OlegNaKone/electronic-analog-audio-spectrum-analizer/media/DSC00884.JPG

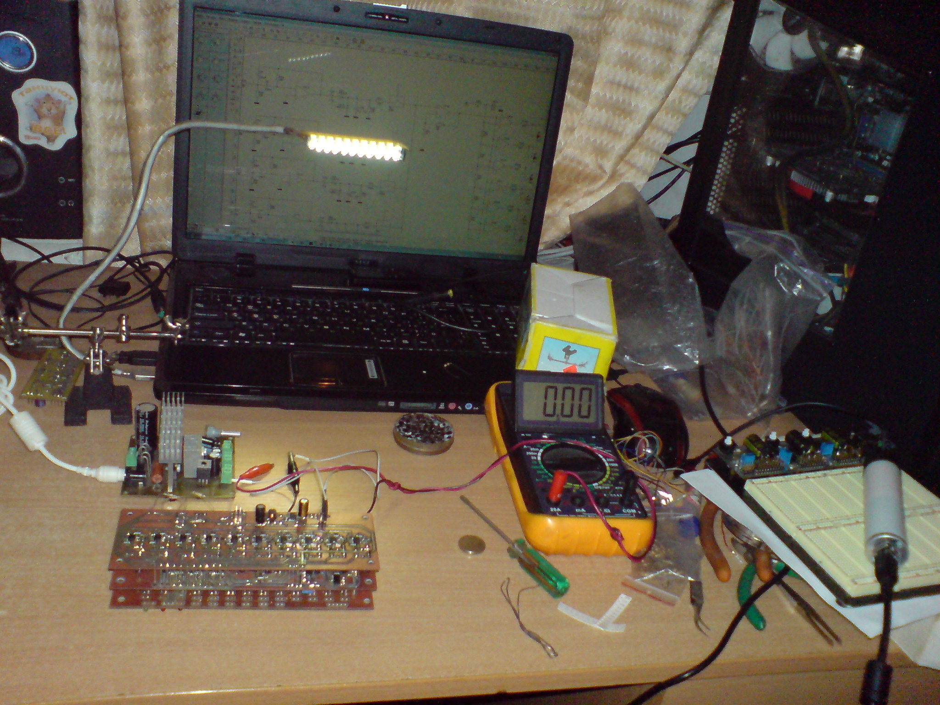
media/DSC00884.JPG
