OlegNaKone/electronic-analog-audio-spectrum-analizer/media/DSC00701.JPG

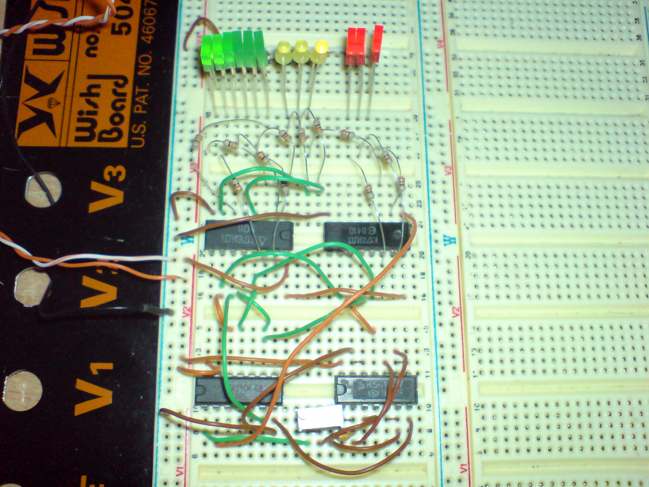
media/DSC00701.JPG
