OlegNaKone/electronic-analog-audio-spectrum-analizer/README.md

# electronic-analog-audio-spectrum-analizer
