OlegNaKone/electronic-analog-audio-spectrum-analizer/article/Логический анализатор1.jpg

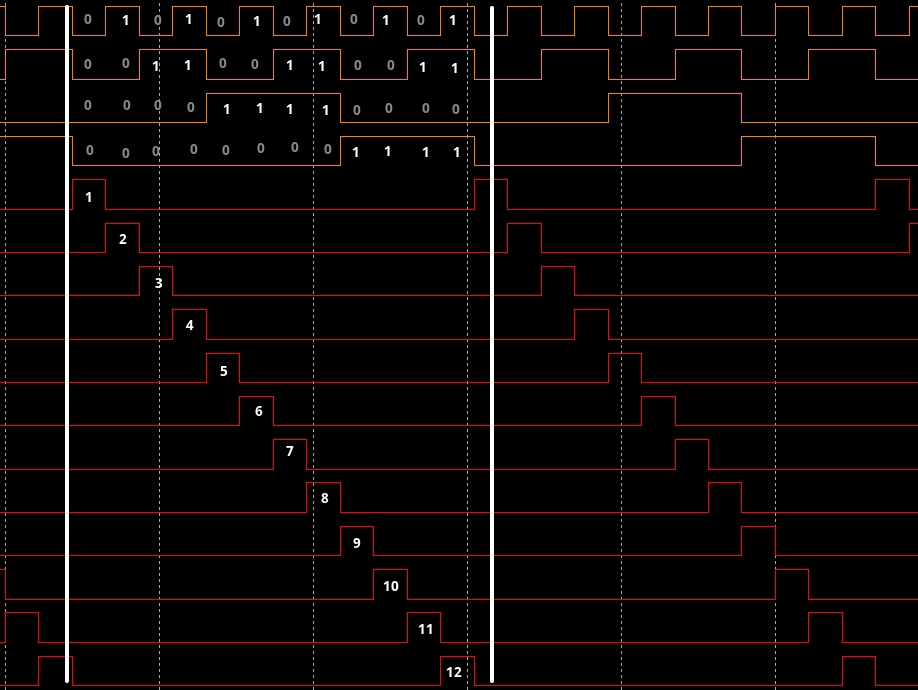
article/Логический анализатор1.jpg
