OlegNaKone/electronic-analog-audio-spectrum-analizer/article/РадиоКот   Десятиканальный аналоговый спектроанализатор_files/01.jpg

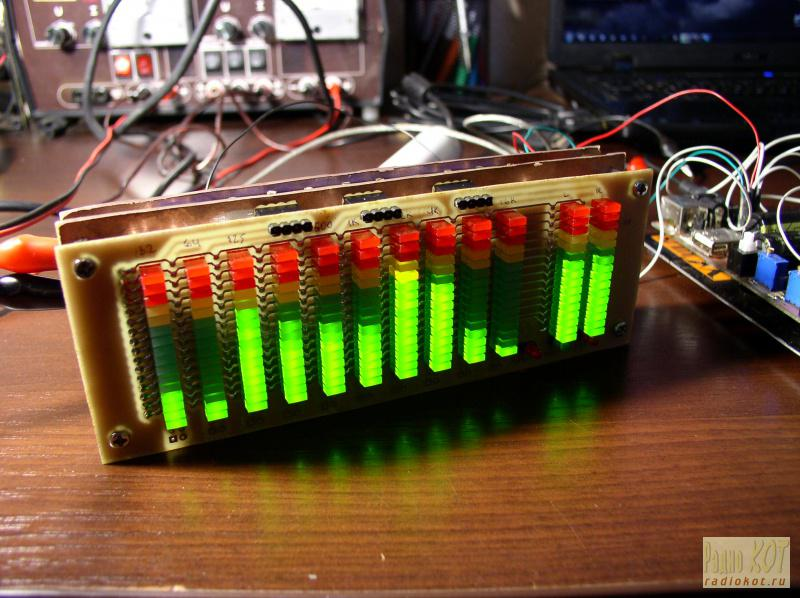
article/РадиоКот Десятиканальный аналоговый спектроанализатор_files/01.jpg
