OlegNaKone/electronic-analog-audio-spectrum-analizer/article/РадиоКот   Десятиканальный аналоговый спектроанализатор_files/03.gif

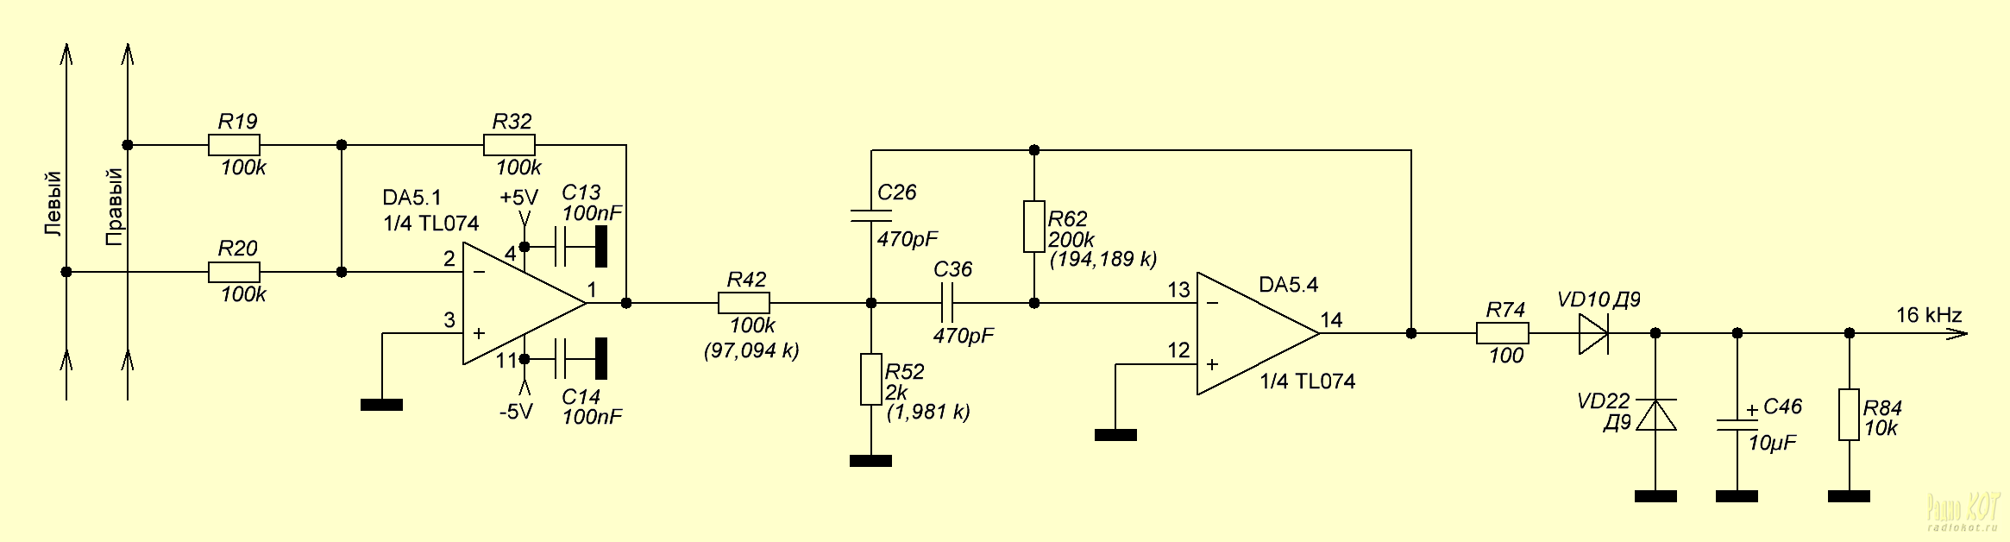
article/РадиоКот Десятиканальный аналоговый спектроанализатор_files/03.gif
