OlegNaKone/electronic-analog-audio-spectrum-analizer/article/РадиоКот   Десятиканальный аналоговый спектроанализатор_files/06_pre.gif

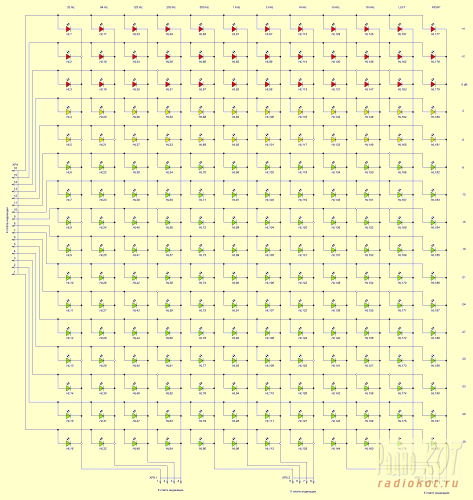
article/РадиоКот Десятиканальный аналоговый спектроанализатор_files/06_pre.gif
