OlegNaKone/electronic-analog-audio-spectrum-analizer/article/РадиоКот   Десятиканальный аналоговый спектроанализатор_files/07_pre.jpg

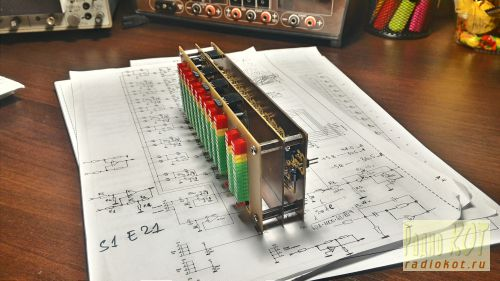
article/РадиоКот Десятиканальный аналоговый спектроанализатор_files/07_pre.jpg
