OlegNaKone/electronic-analog-audio-spectrum-analizer/article/схема блока индикаторов.GIF

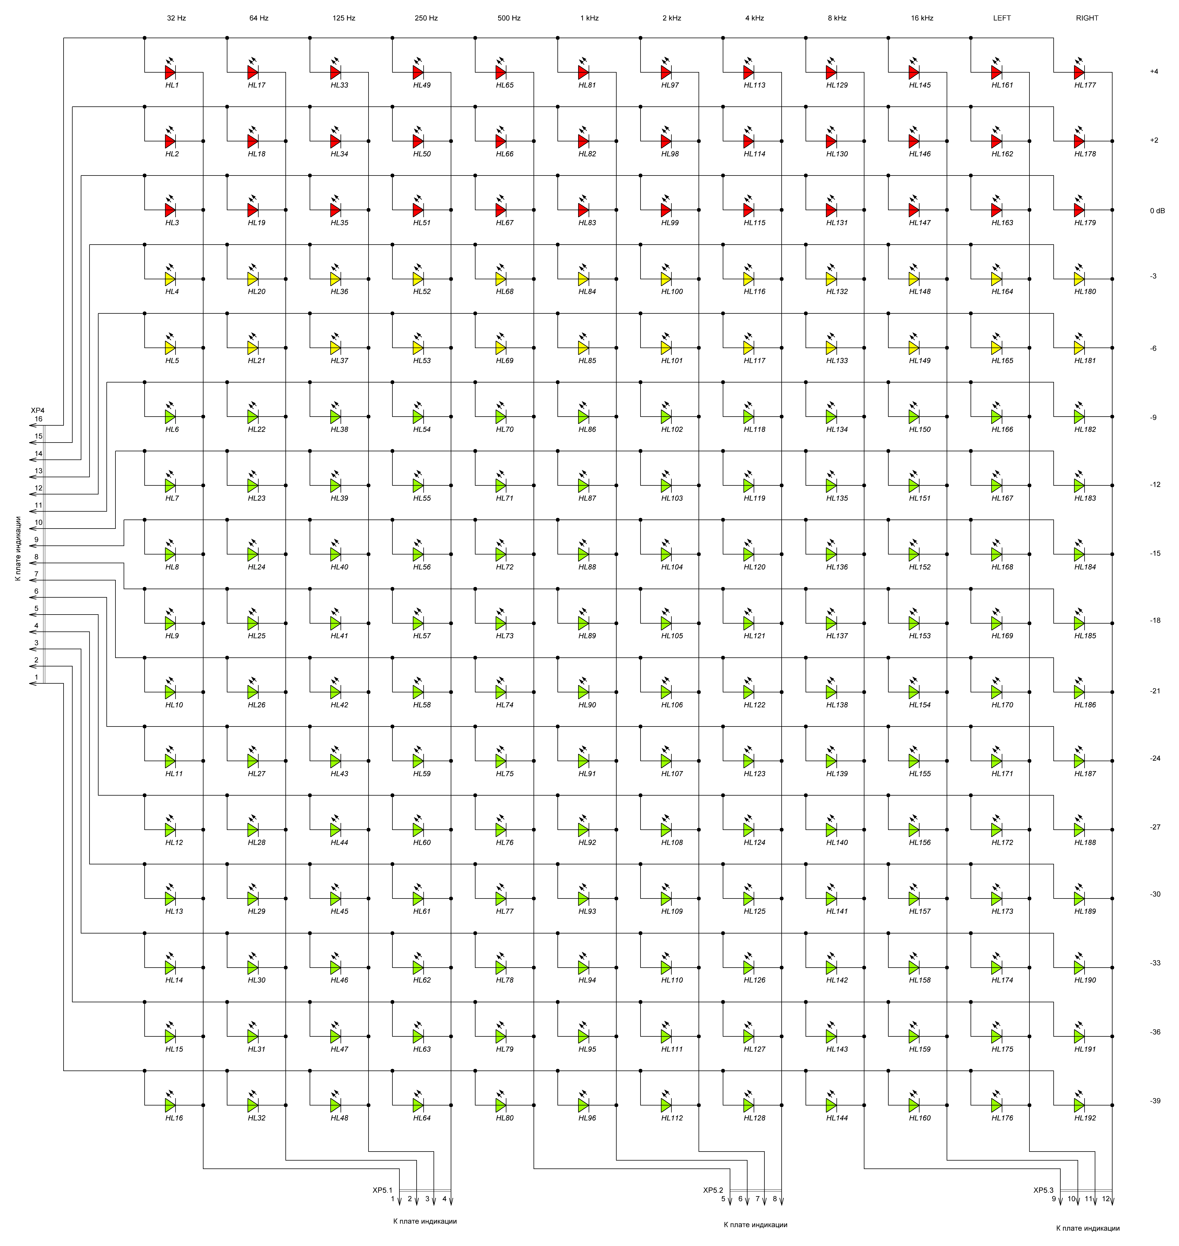
article/схема блока индикаторов.GIF
