OlegNaKone/electronic-analog-audio-spectrum-analizer/article/схема блока индикации.GIF

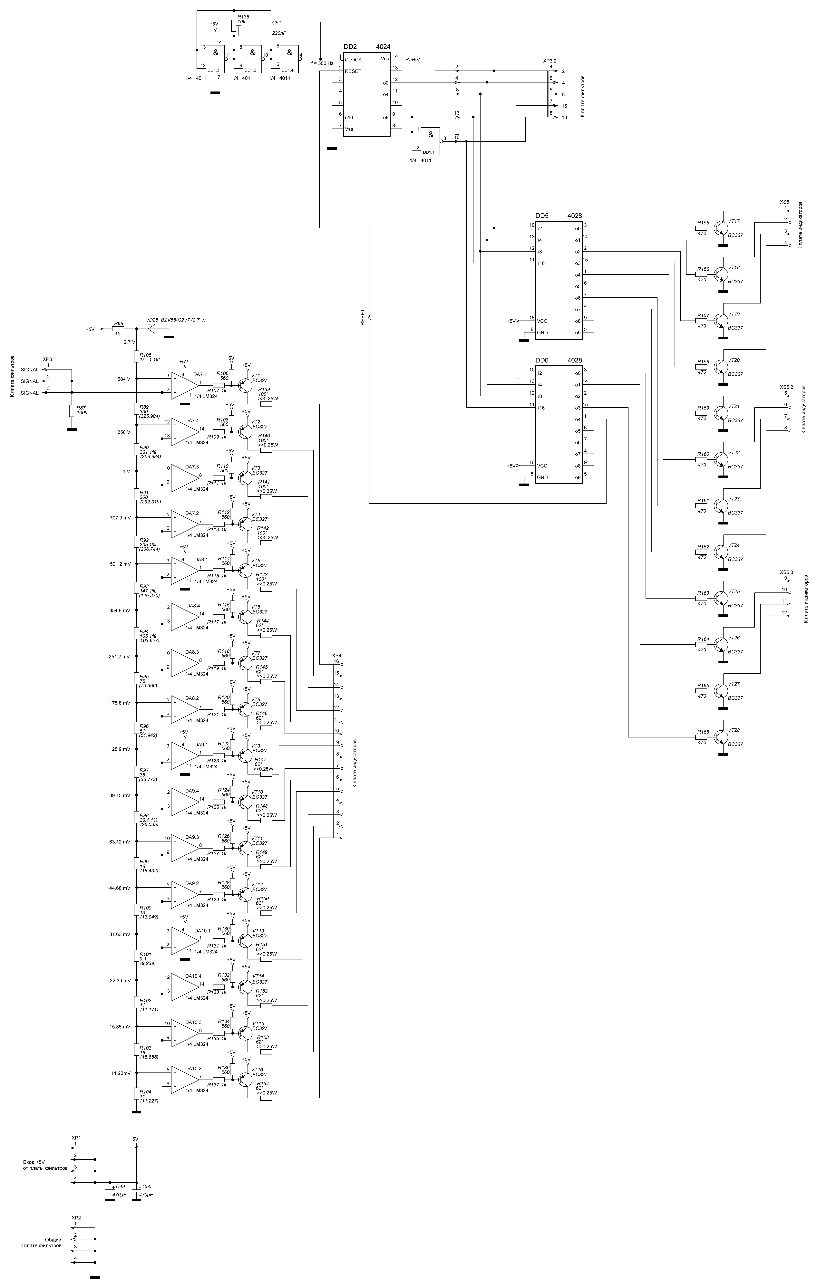
article/схема блока индикации.GIF
