OlegNaKone/electronic-analog-audio-spectrum-analizer/article/схема блока фильтров.GIF

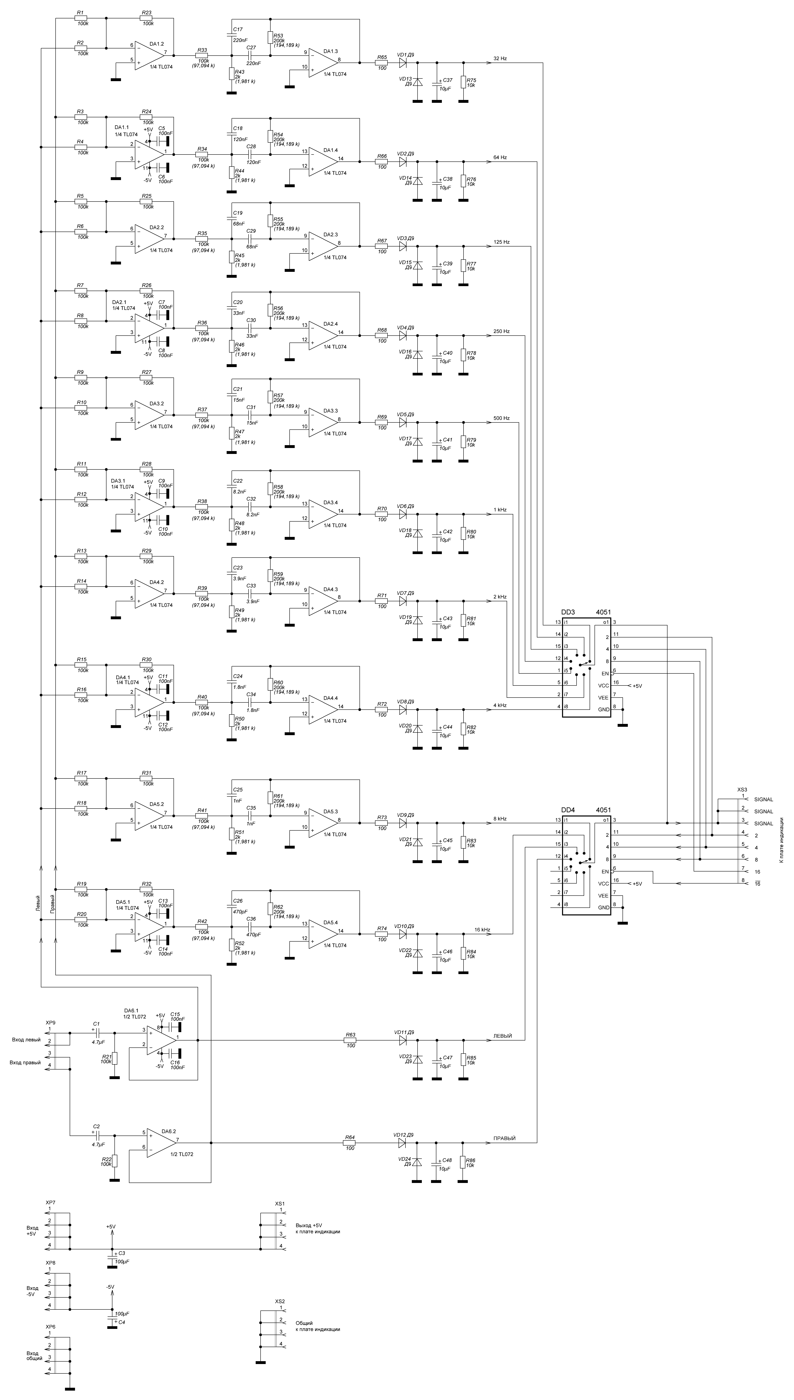
article/схема блока фильтров.GIF
