OlegNaKone/electronic-analog-audio-spectrum-analizer/media/DSC00006.JPG

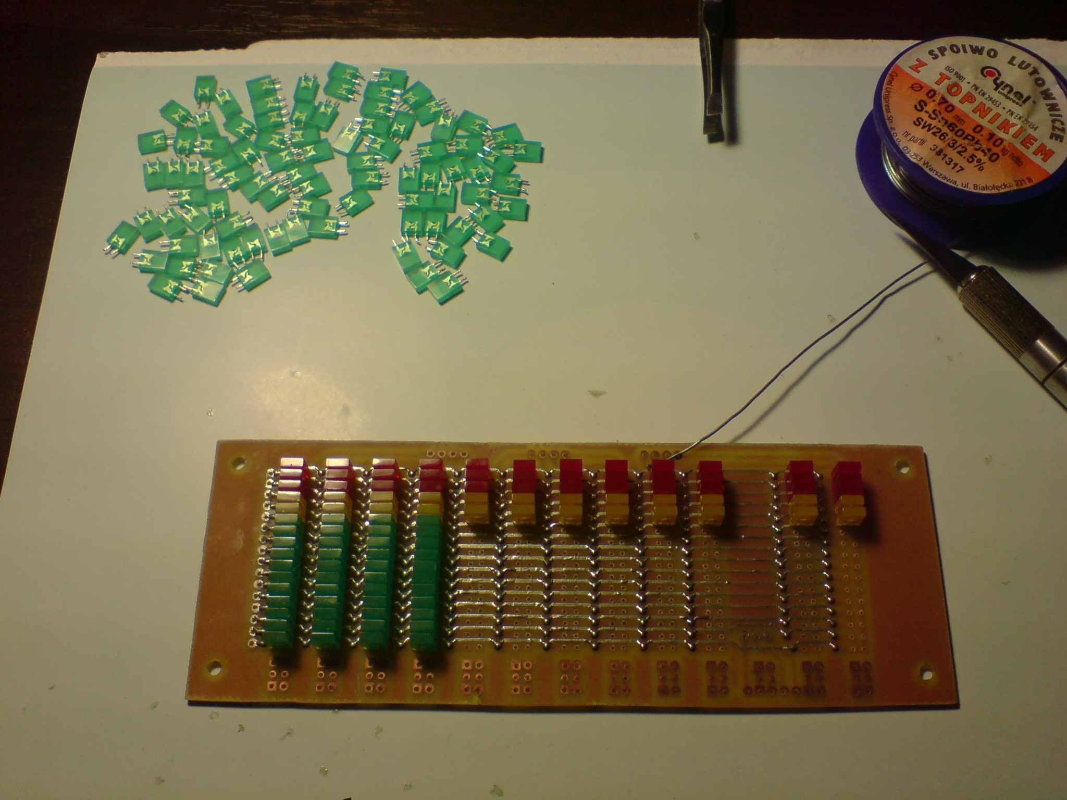
media/DSC00006.JPG
