OlegNaKone/electronic-analog-audio-spectrum-analizer/media/DSC00011.JPG

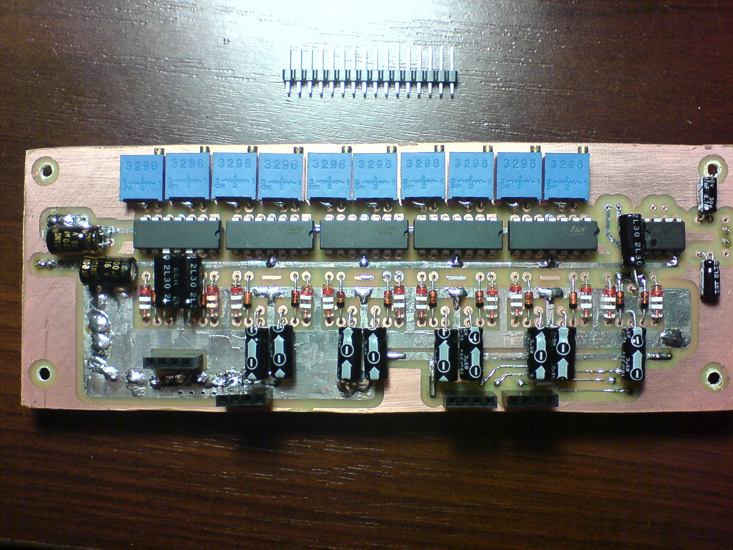
media/DSC00011.JPG
