OlegNaKone/electronic-analog-audio-spectrum-analizer/media/DSC00014.JPG

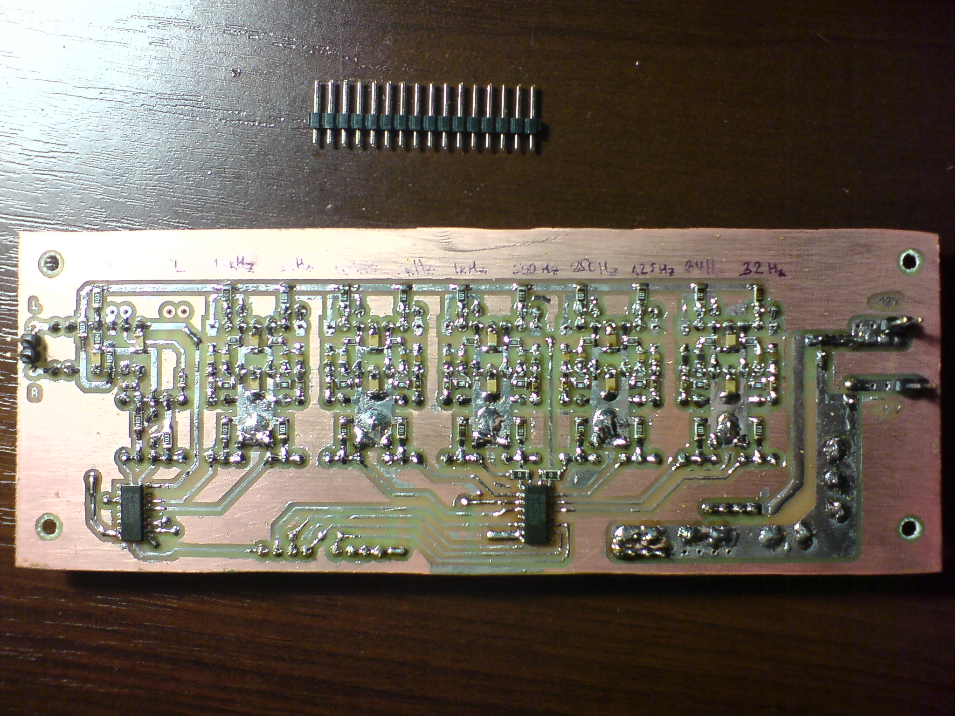
media/DSC00014.JPG
