OlegNaKone/electronic-analog-audio-spectrum-analizer/media/DSC00016.JPG

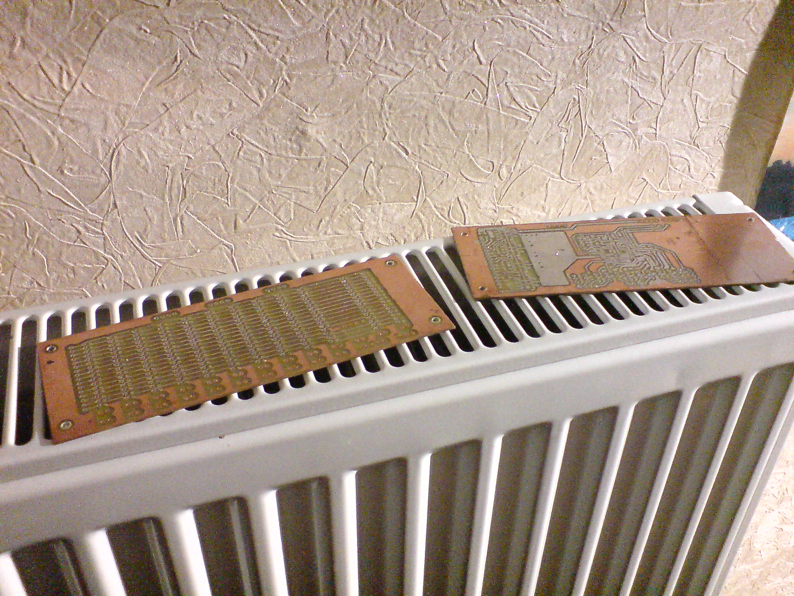
media/DSC00016.JPG
