OlegNaKone/electronic-analog-audio-spectrum-analizer/media/DSC00018.JPG

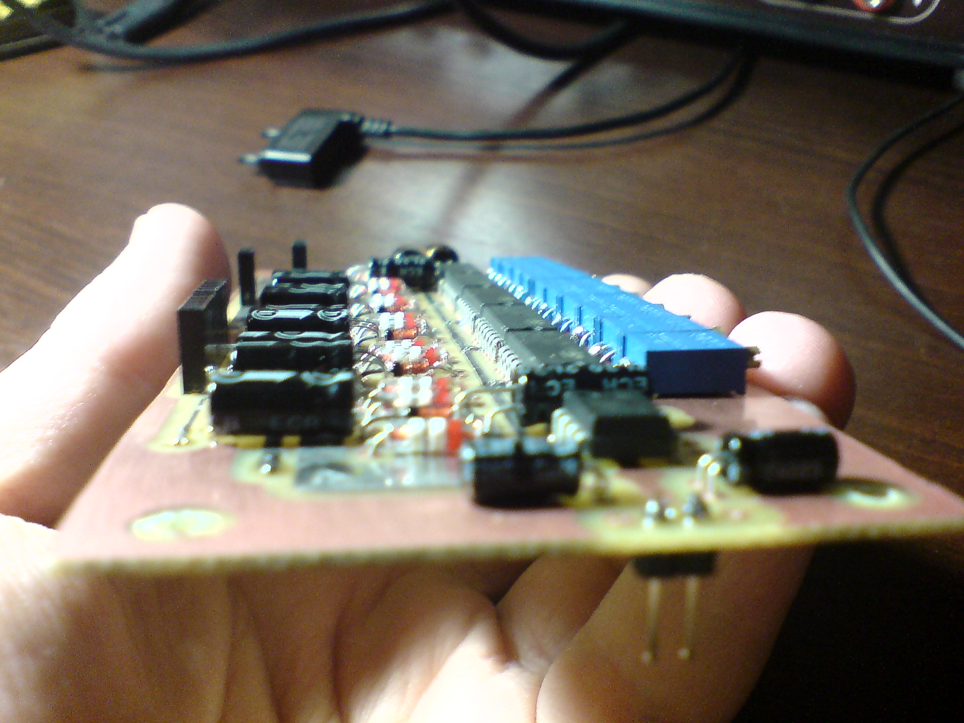
media/DSC00018.JPG
