OlegNaKone/electronic-analog-audio-spectrum-analizer/media/DSC00019.JPG

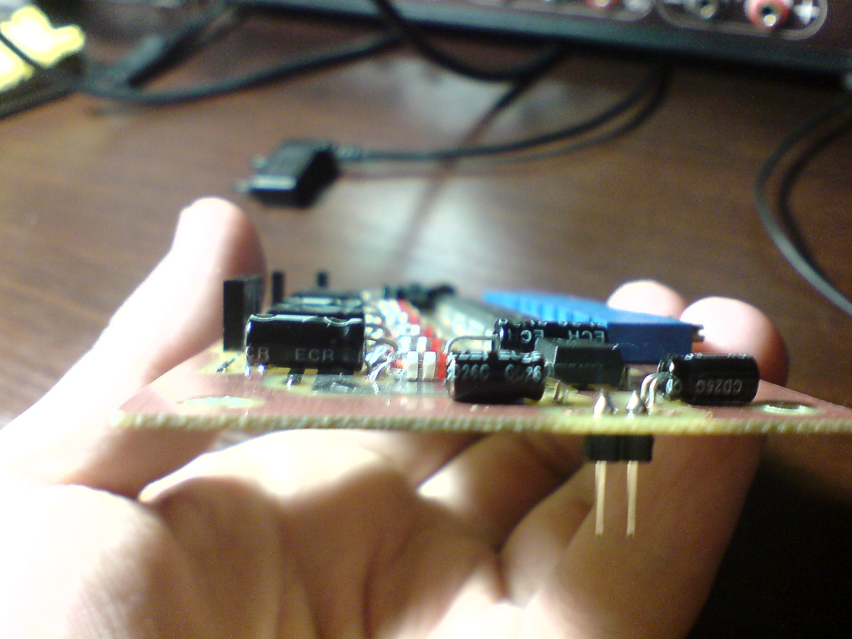
media/DSC00019.JPG
