OlegNaKone/electronic-analog-audio-spectrum-analizer/media/DSC00020.JPG

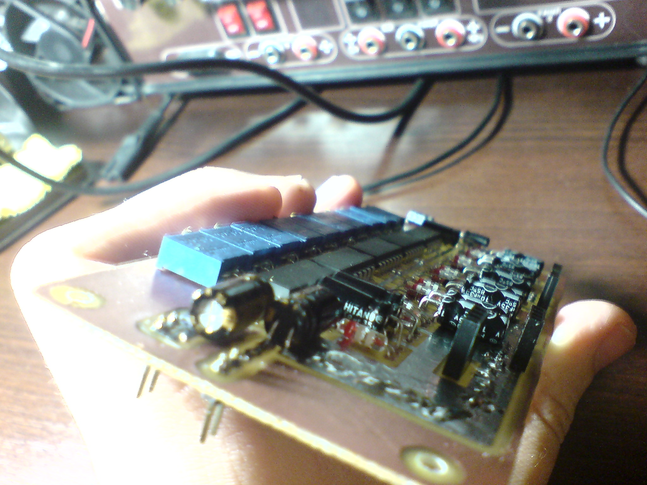
media/DSC00020.JPG
