OlegNaKone/electronic-analog-audio-spectrum-analizer/media/DSC00700.JPG

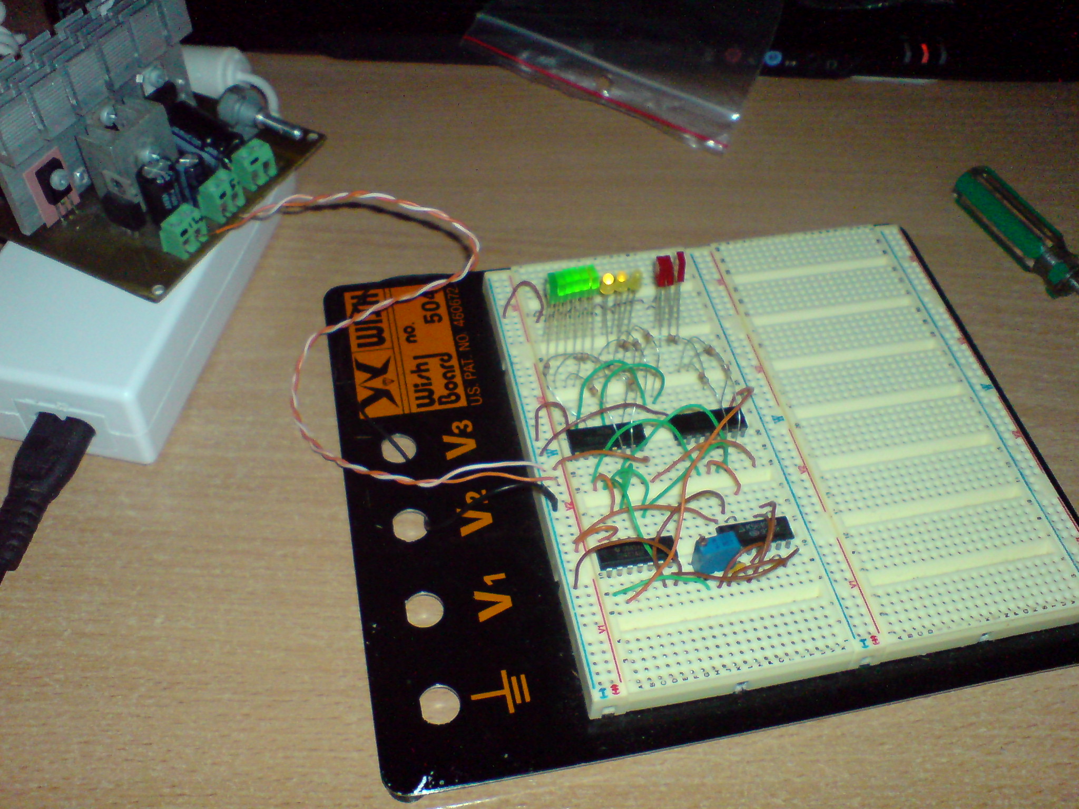
media/DSC00700.JPG
