OlegNaKone/electronic-analog-audio-spectrum-analizer/media/DSC00827.JPG

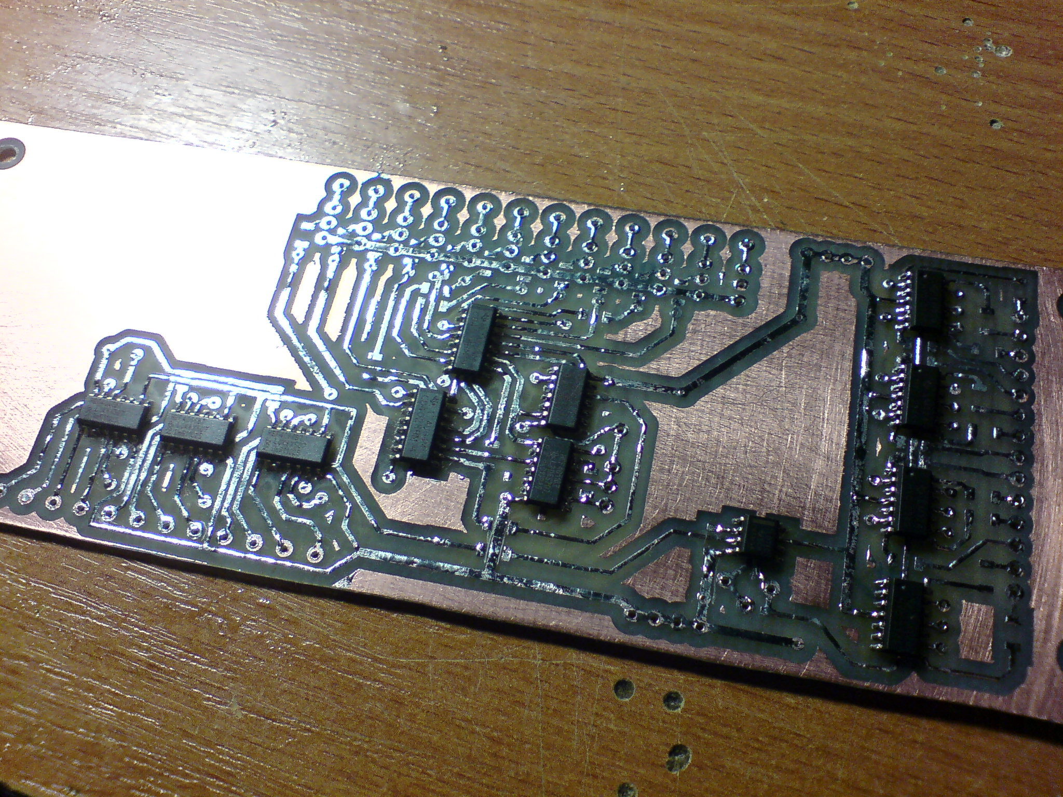
media/DSC00827.JPG
