OlegNaKone/electronic-analog-audio-spectrum-analizer/media/DSC00828.JPG

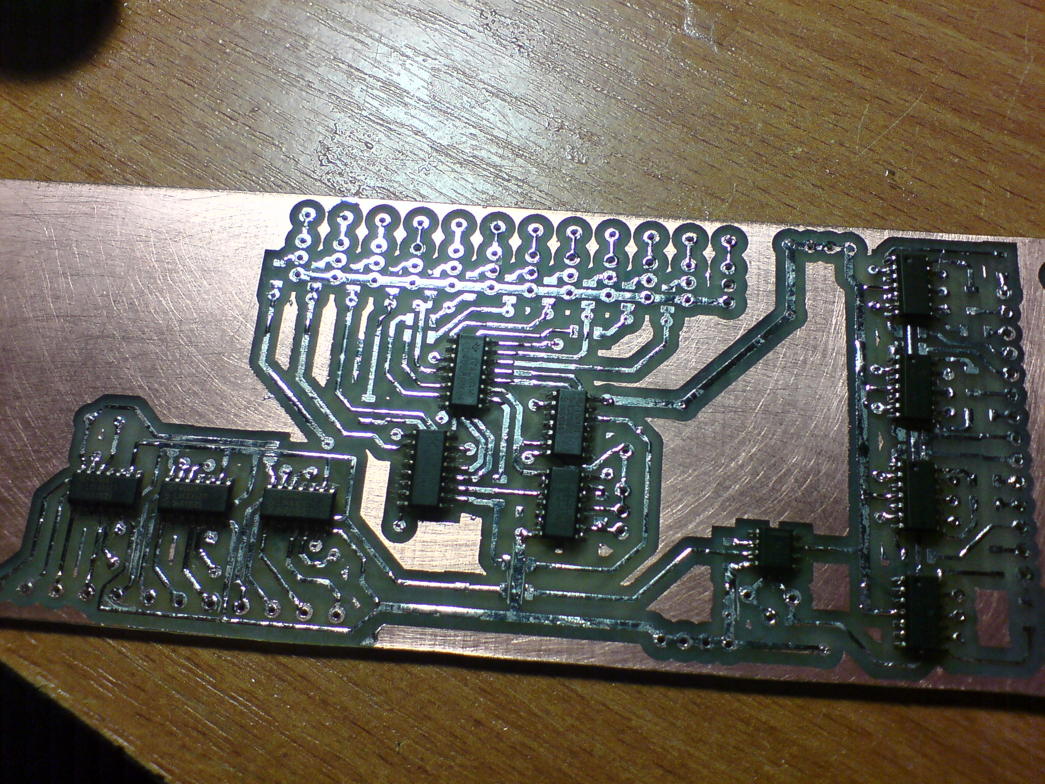
media/DSC00828.JPG
