OlegNaKone/electronic-analog-audio-spectrum-analizer/media/DSC00859.JPG

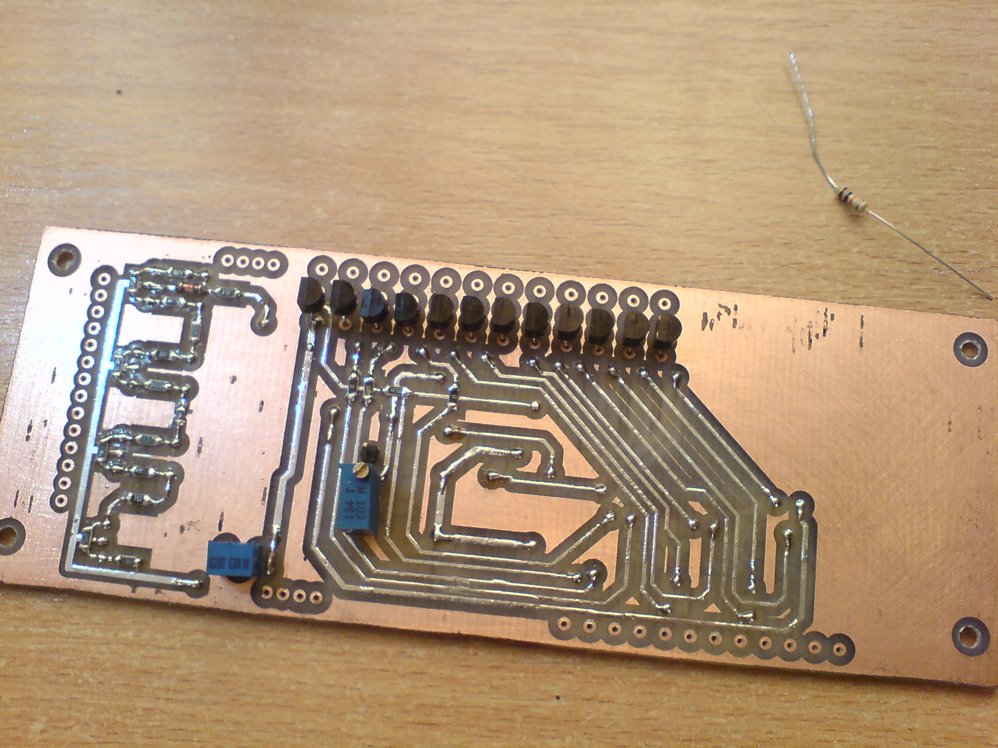
media/DSC00859.JPG
