OlegNaKone/electronic-analog-audio-spectrum-analizer/media/DSC00860.JPG

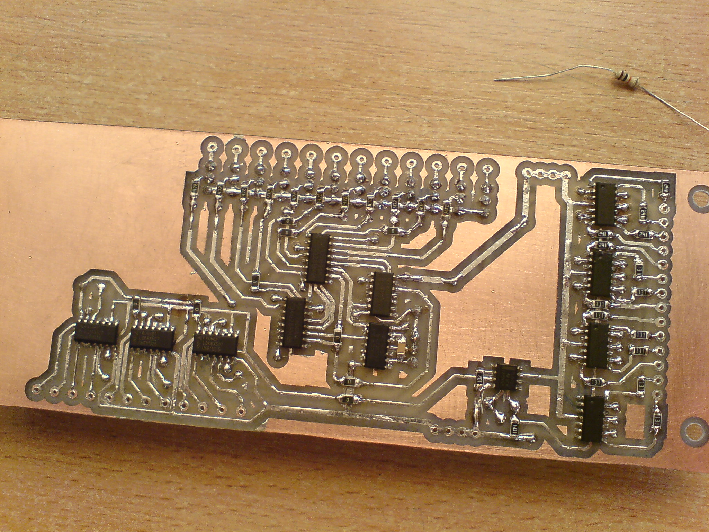
media/DSC00860.JPG
