OlegNaKone/electronic-analog-audio-spectrum-analizer/media/DSC00861.JPG

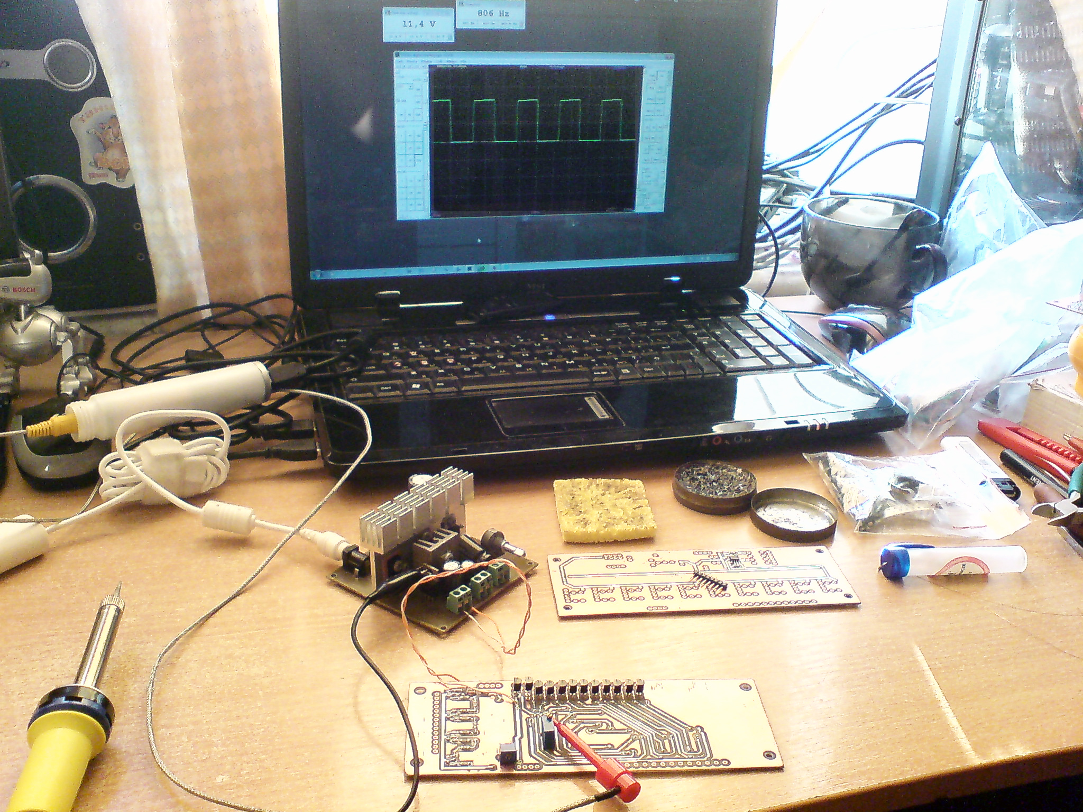
media/DSC00861.JPG
