OlegNaKone/electronic-analog-audio-spectrum-analizer/media/DSC00871.JPG

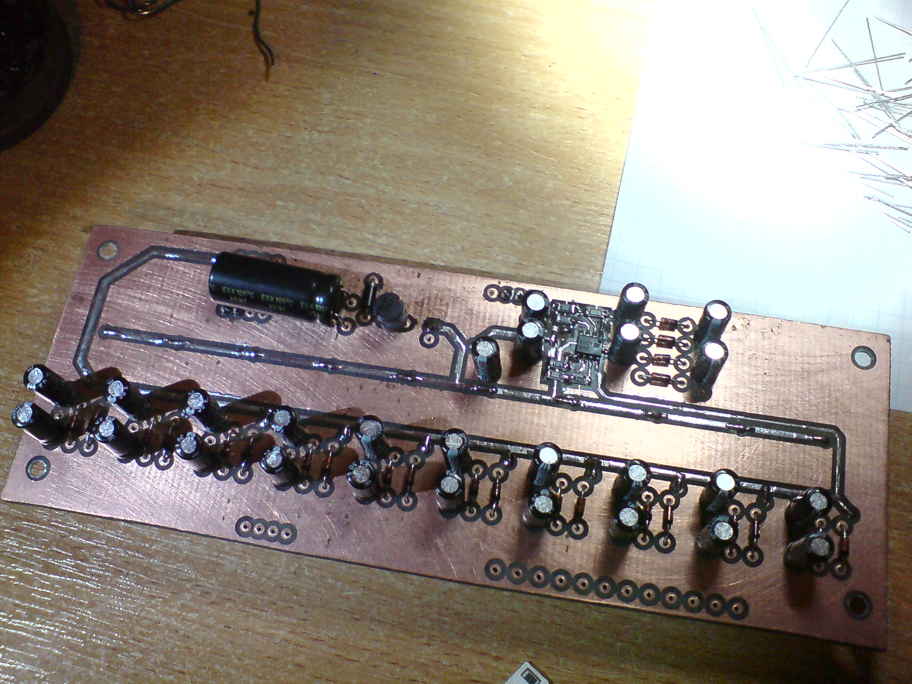
media/DSC00871.JPG
