OlegNaKone/electronic-analog-audio-spectrum-analizer/media/DSC00874.JPG

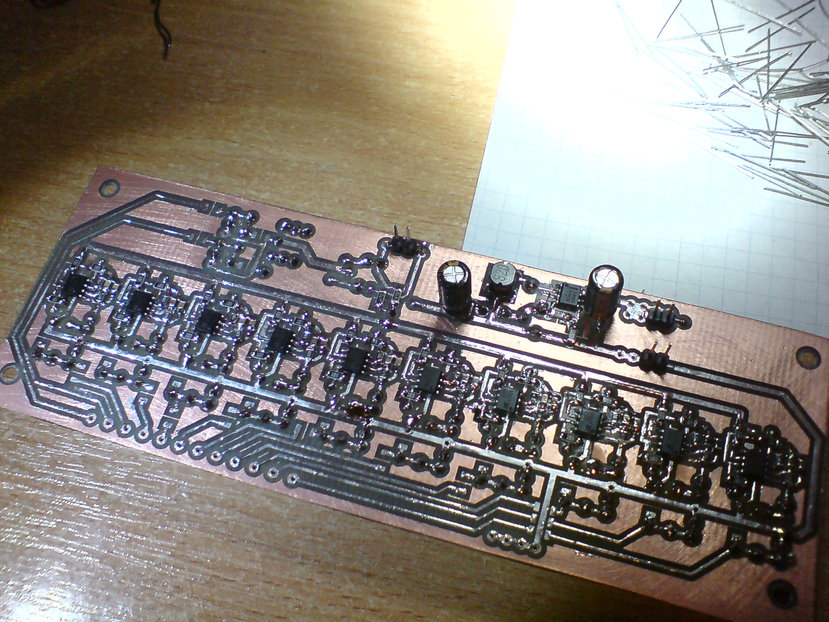
media/DSC00874.JPG
