OlegNaKone/electronic-analog-audio-spectrum-analizer/media/DSC00879.JPG

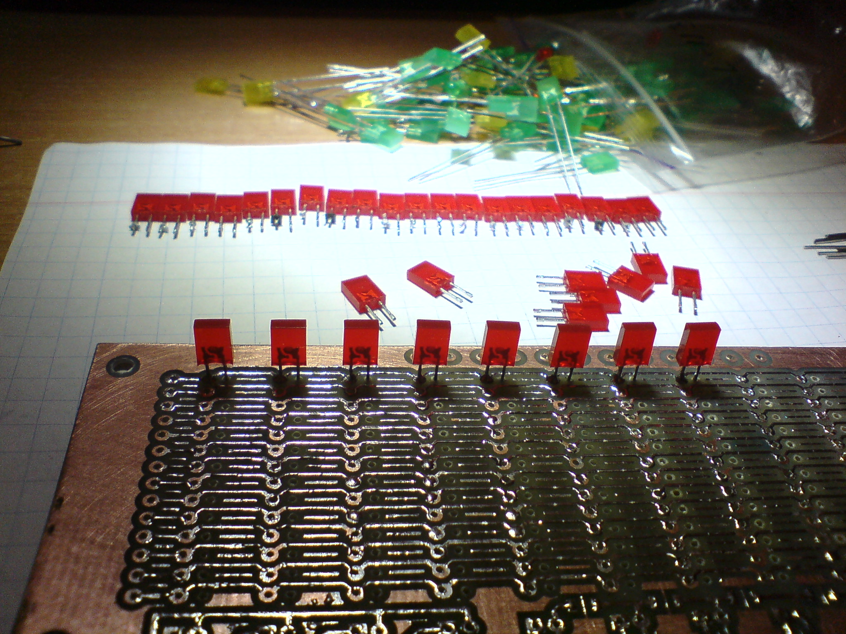
media/DSC00879.JPG
