OlegNaKone/electronic-analog-audio-spectrum-analizer/media/DSC00882.JPG

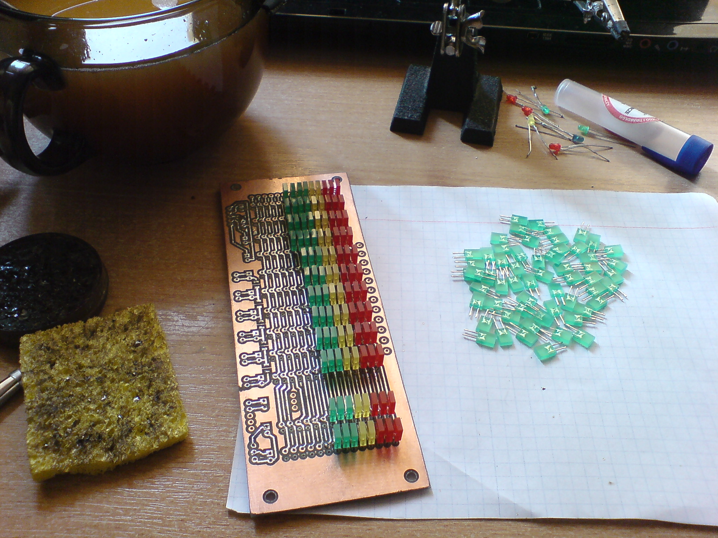
media/DSC00882.JPG
