OlegNaKone/electronic-analog-audio-spectrum-analizer/media/DSC00911.JPG

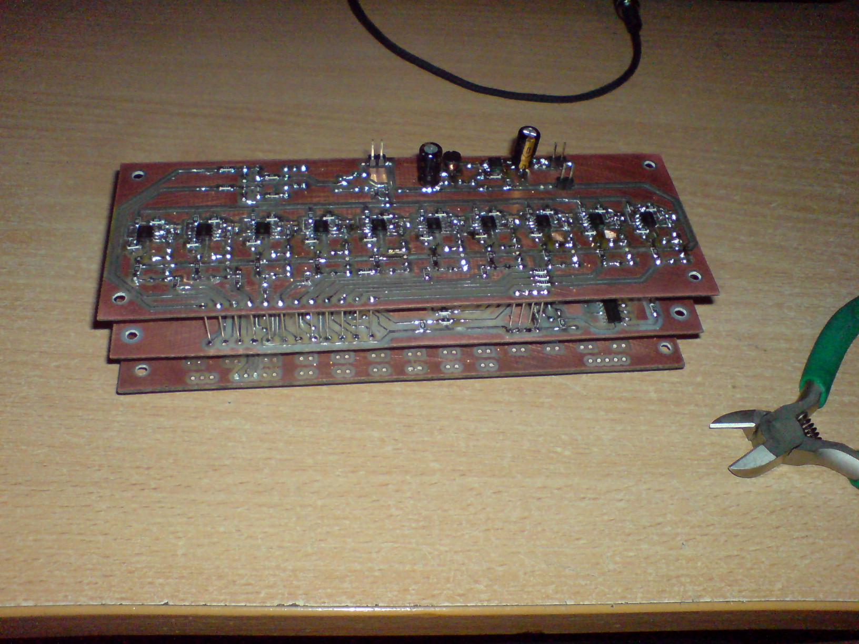
media/DSC00911.JPG
