OlegNaKone/electronic-analog-audio-spectrum-analizer/media/HCV7FlaQQp8.jpg

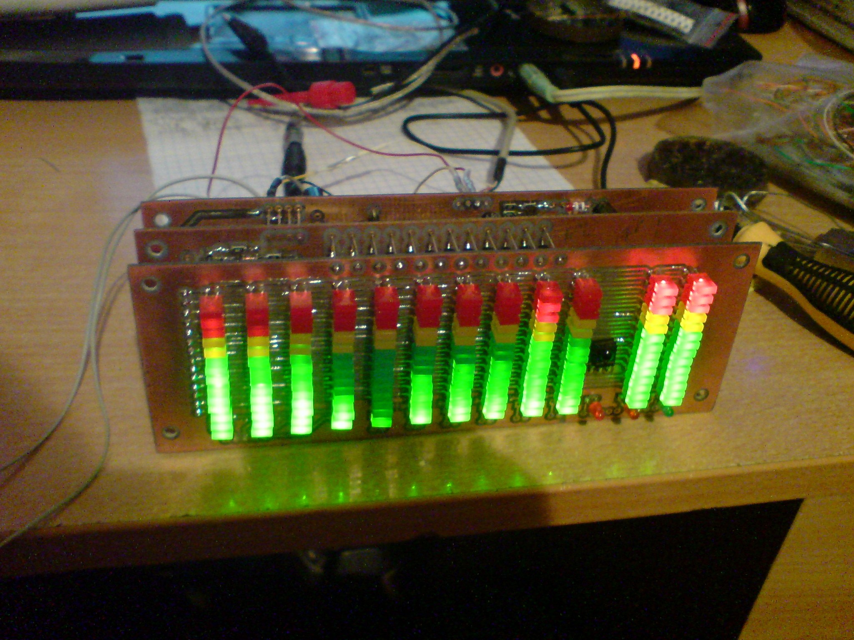
media/HCV7FlaQQp8.jpg
