OlegNaKone/electronic-analog-audio-spectrum-analizer/media/P1010004.JPG

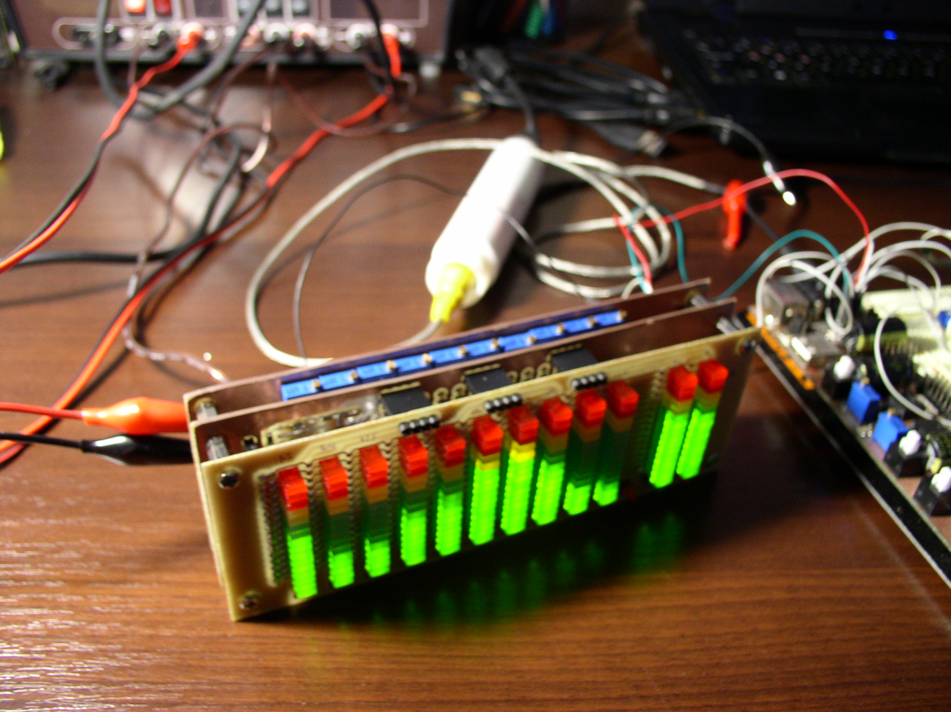
media/P1010004.JPG
