OlegNaKone/electronic-analog-audio-spectrum-analizer/media/P_20151008_032055.jpg

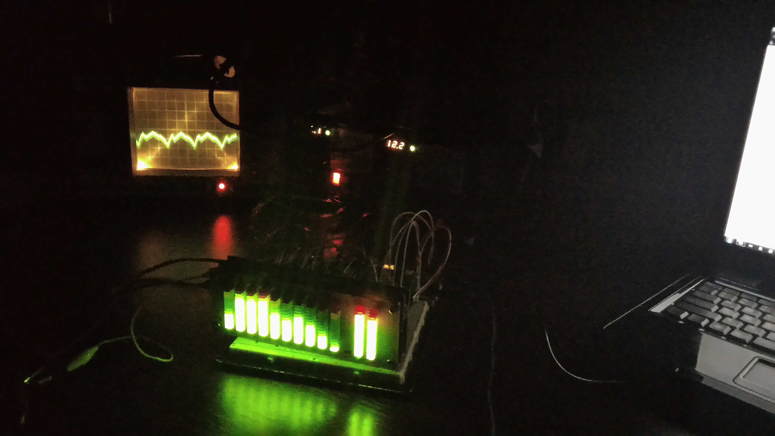
media/P_20151008_032055.jpg
