OlegNaKone/electronic-analog-audio-spectrum-analizer/media/P_20151105_224428_HDR.jpg

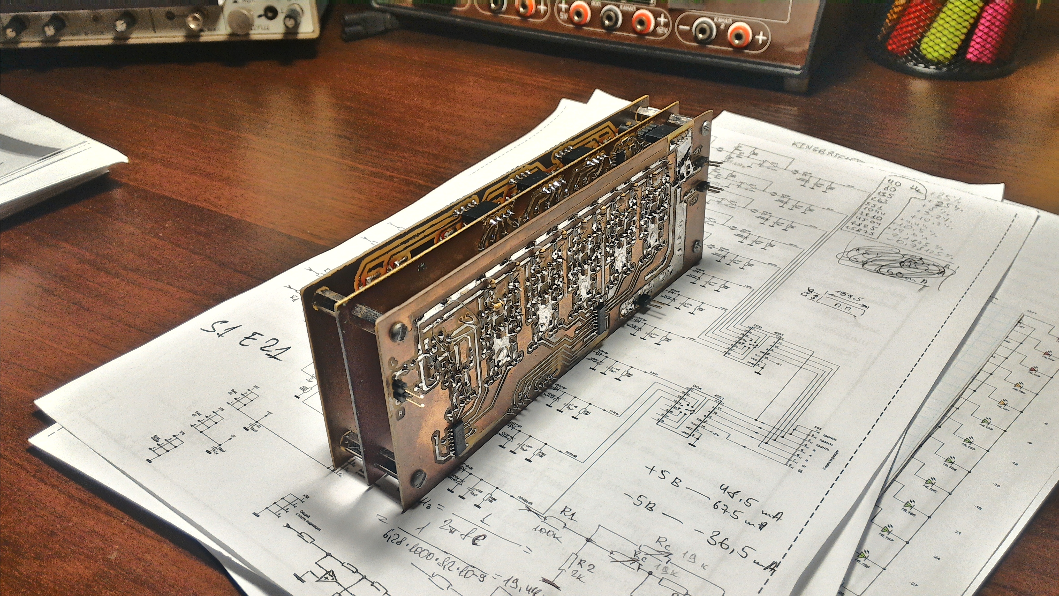
media/P_20151105_224428_HDR.jpg
