OlegNaKone/electronic-analog-audio-spectrum-analizer/media/P_20151105_224526.jpg

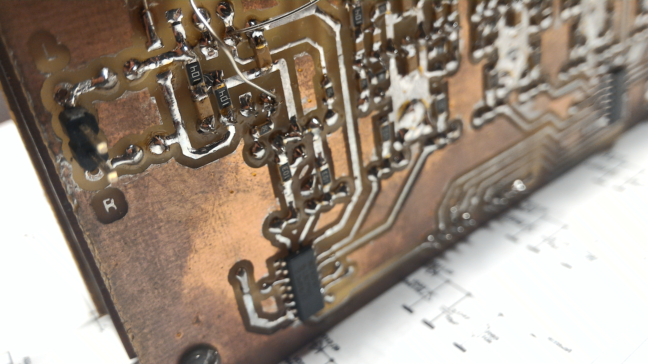
media/P_20151105_224526.jpg
