OlegNaKone/electronic-analog-audio-spectrum-analizer/media/P_20151105_224538.jpg

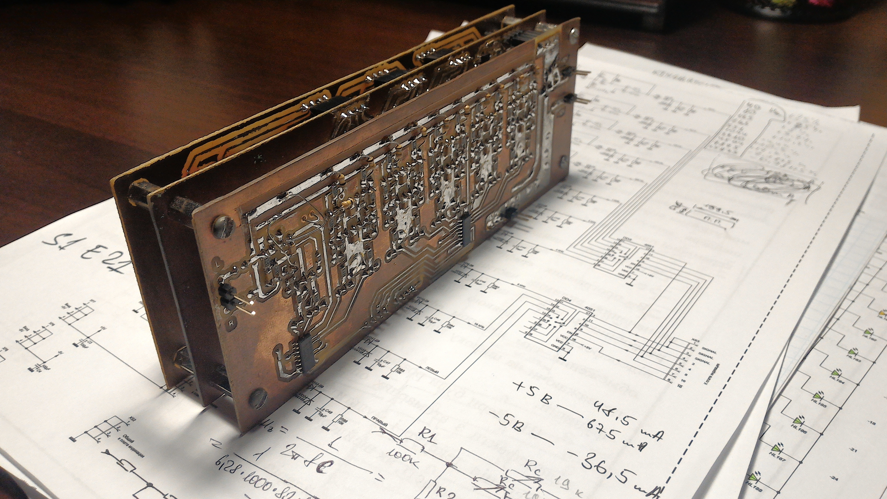
media/P_20151105_224538.jpg
