OlegNaKone/electronic-analog-audio-spectrum-analizer/media/P_20151105_224550.jpg

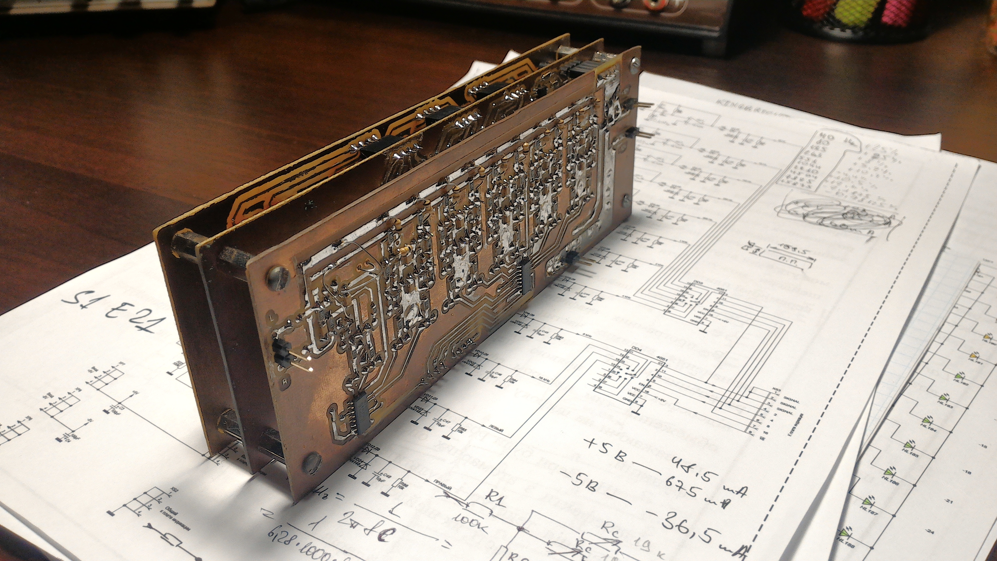
media/P_20151105_224550.jpg
