OlegNaKone/electronic-analog-audio-spectrum-analizer/media/P_20151105_224935.jpg

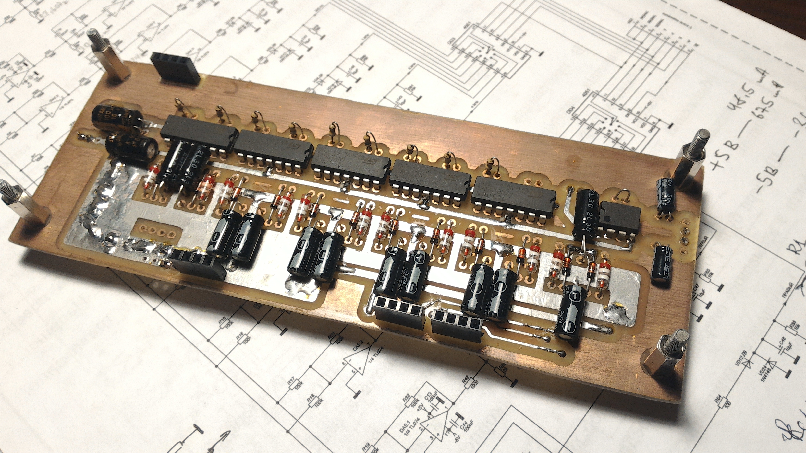
media/P_20151105_224935.jpg
