OlegNaKone/electronic-analog-audio-spectrum-analizer/media/P_20151105_225125.jpg

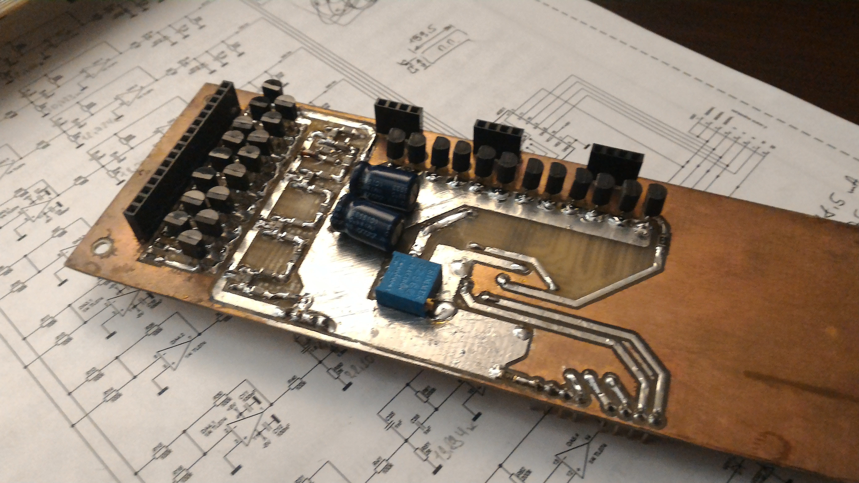
media/P_20151105_225125.jpg
