OlegNaKone/electronic-analog-audio-spectrum-analizer/(list of files, drawings)

Other design files:
article/платы.lay
article/схема.spl7
circuit.spl7
