OlegNaKone/electronic-analog-audio-spectrum-analizer/(commit log)

2022-04-06 added source files
    [circuit.spl7, pcb.lay, resistors-calc.xlsx]
2022-04-06 added article for radiokot.ru
    [платы.lay, схема.spl7]
